MooVx/Project_mobil/Zdjecia etap 2/PCB.jpg

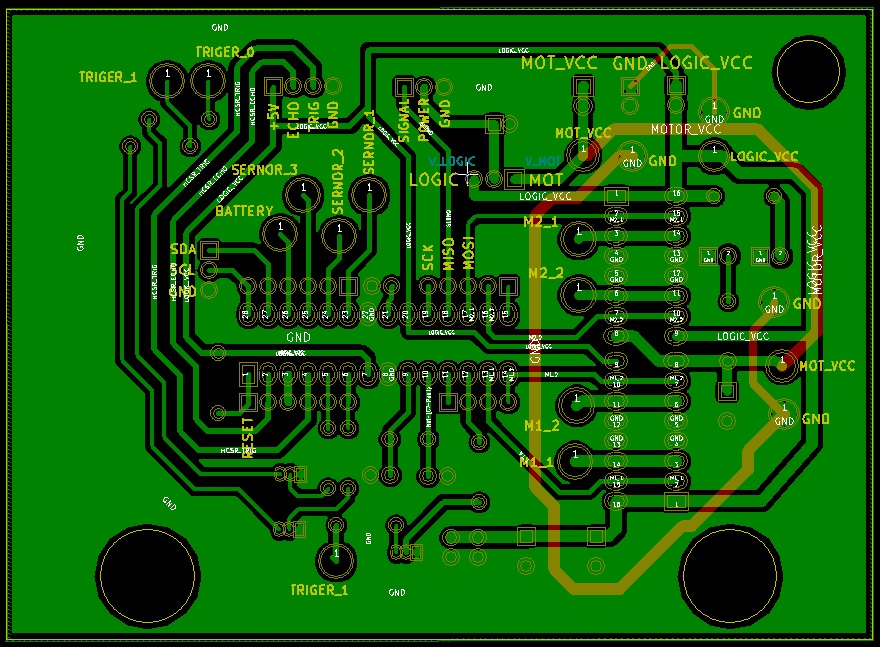
Zdjecia etap 2/PCB.jpg
