MooVx/Project_mobil/Zdjecia etap1/Sensor_trigger_calc_sch.jpg

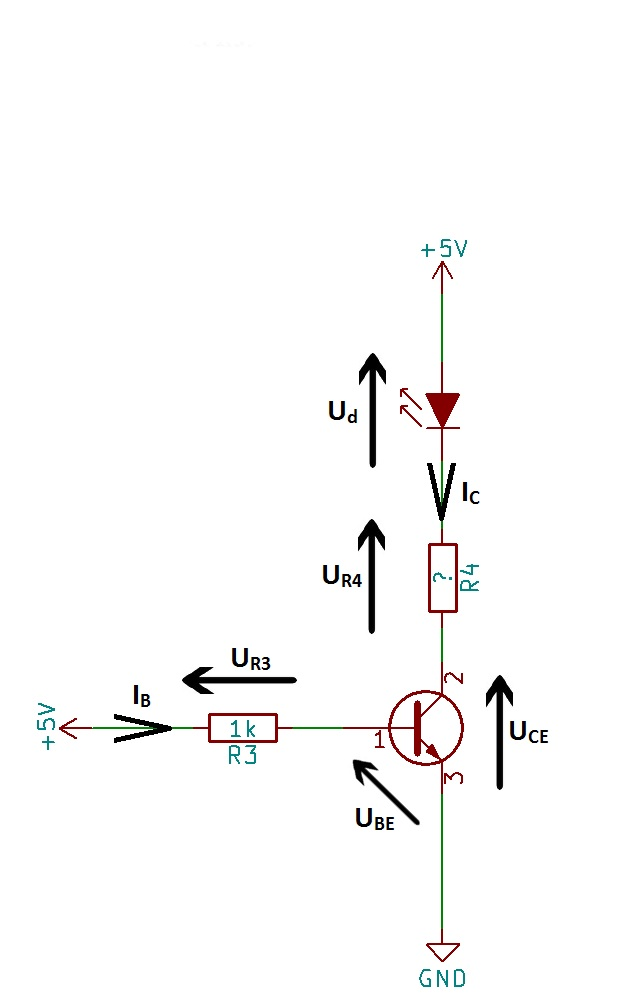
Zdjecia etap1/Sensor_trigger_calc_sch.jpg
