MooVx/Project_mobil/Zdjecia etap1/Wyprowadzenie_zasilania_sch.jpg

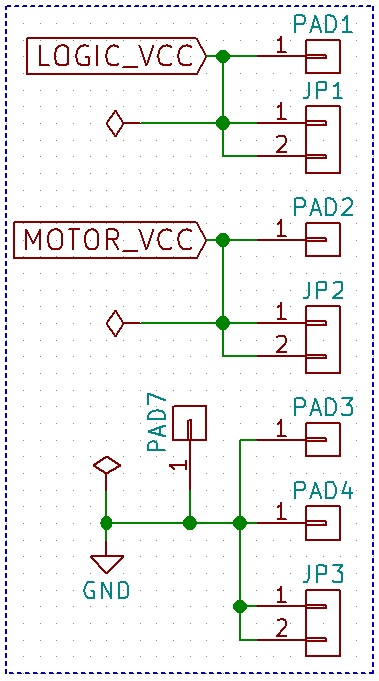
Zdjecia etap1/Wyprowadzenie_zasilania_sch.jpg
