MooVx/Project_mobil/Zdjecia etap 2/20170325_141044.jpg

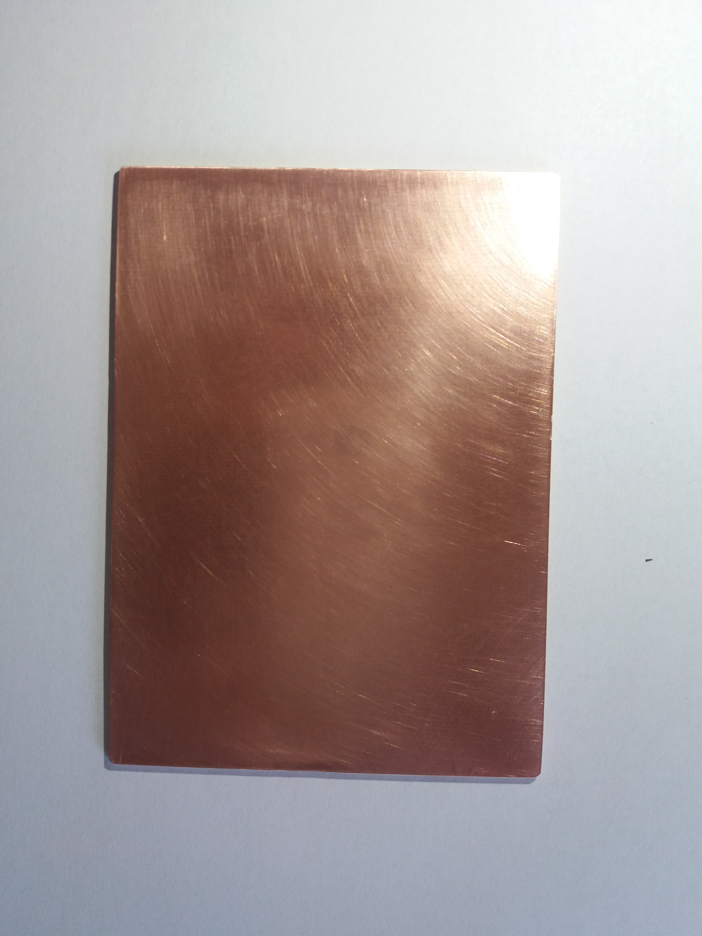
Zdjecia etap 2/20170325_141044.jpg
