MooVx/Project_mobil/Zdjecia etap 2/20170325_141538.jpg

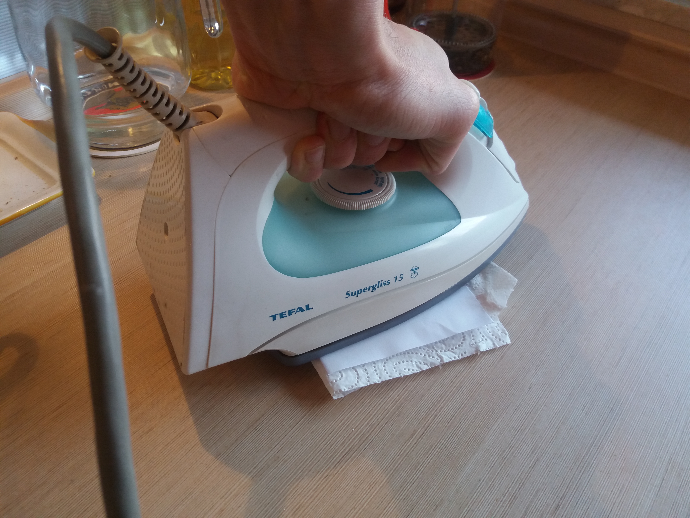
Zdjecia etap 2/20170325_141538.jpg
