MooVx/Project_mobil/Zdjecia etap 2/20170325_144329.jpg

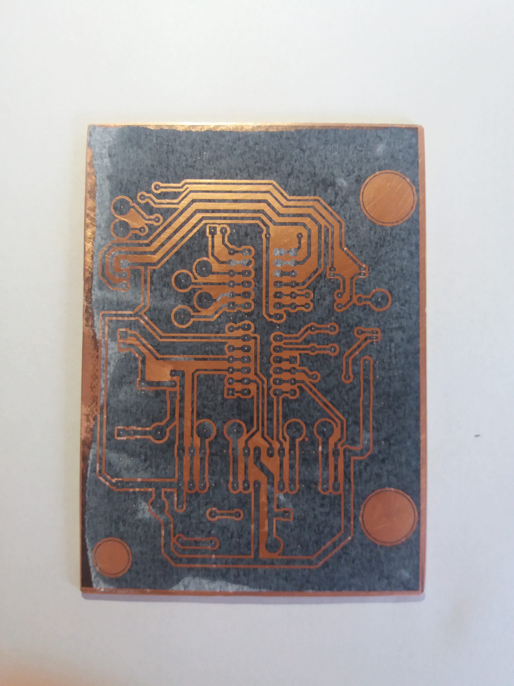
Zdjecia etap 2/20170325_144329.jpg
