MooVx/Project_mobil/Zdjecia etap 2/20170325_145545.jpg

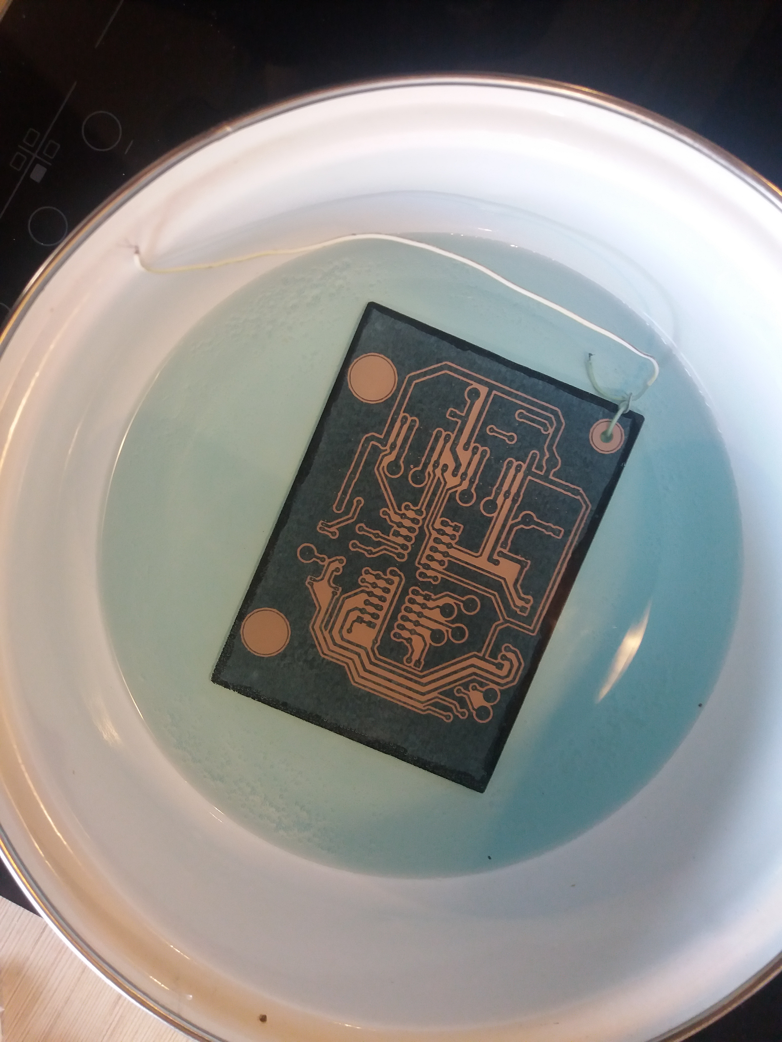
Zdjecia etap 2/20170325_145545.jpg
