MooVx/Project_mobil/Zdjecia etap 2/20170325_151509.jpg

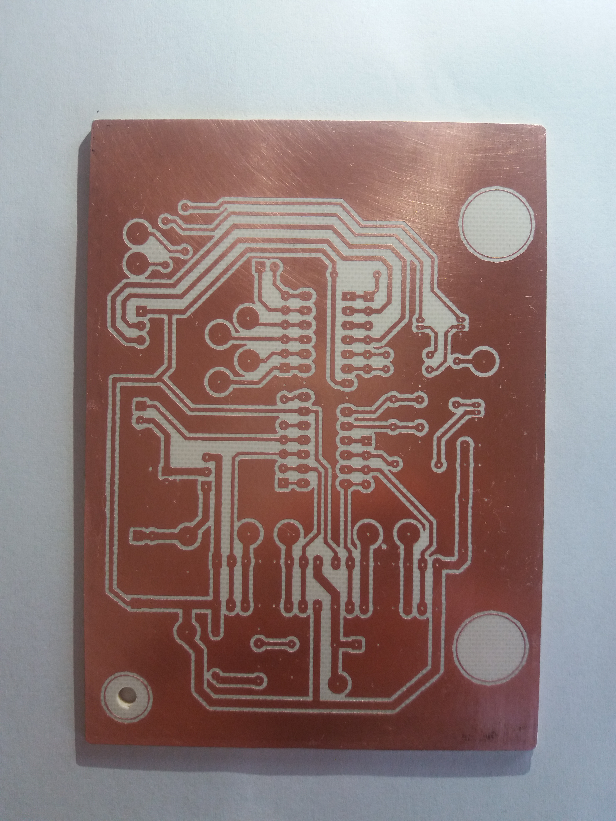
Zdjecia etap 2/20170325_151509.jpg
