MooVx/Project_mobil/Zdjecia etap 2/20170325_154758.jpg

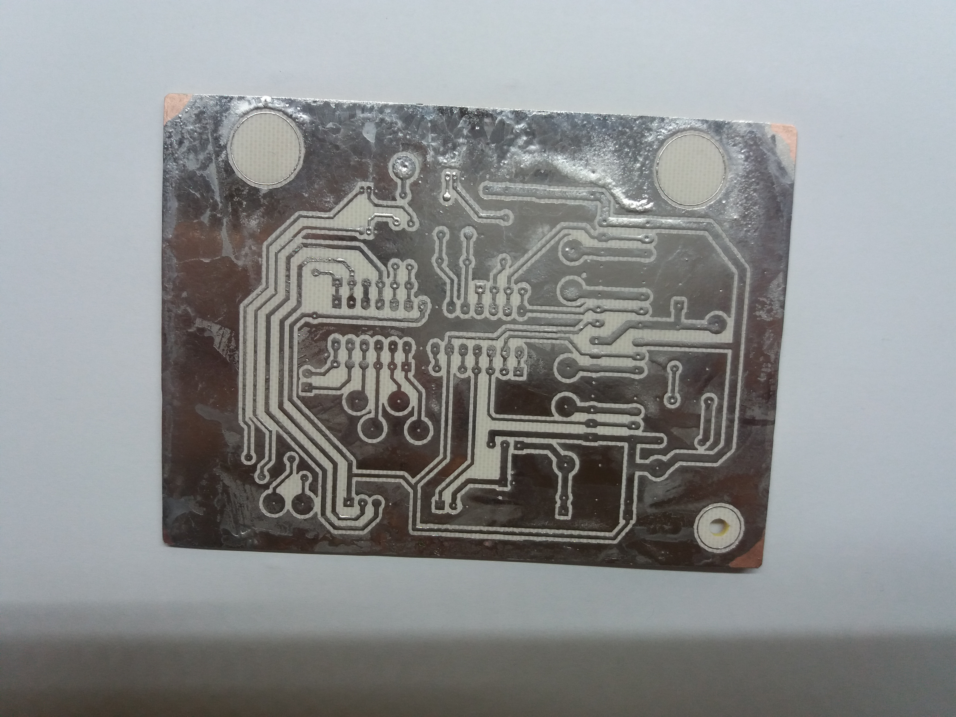
Zdjecia etap 2/20170325_154758.jpg
