MooVx/Project_mobil/Zdjecia etap 2/20170325_160751.jpg

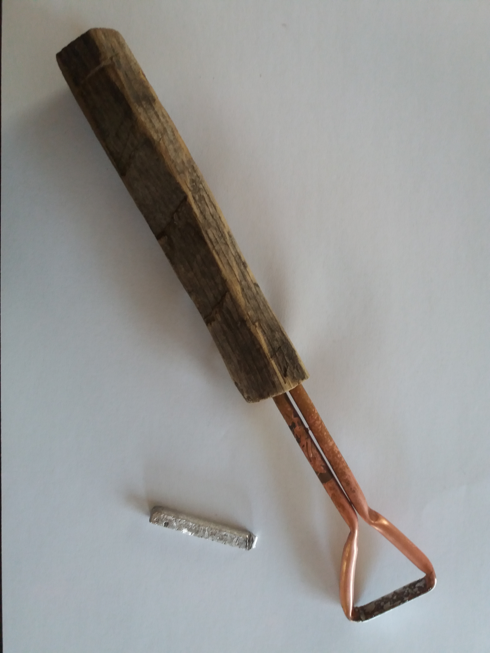
Zdjecia etap 2/20170325_160751.jpg
