MooVx/Project_mobil/Zdjecia etap 2/20170325_161032.jpg

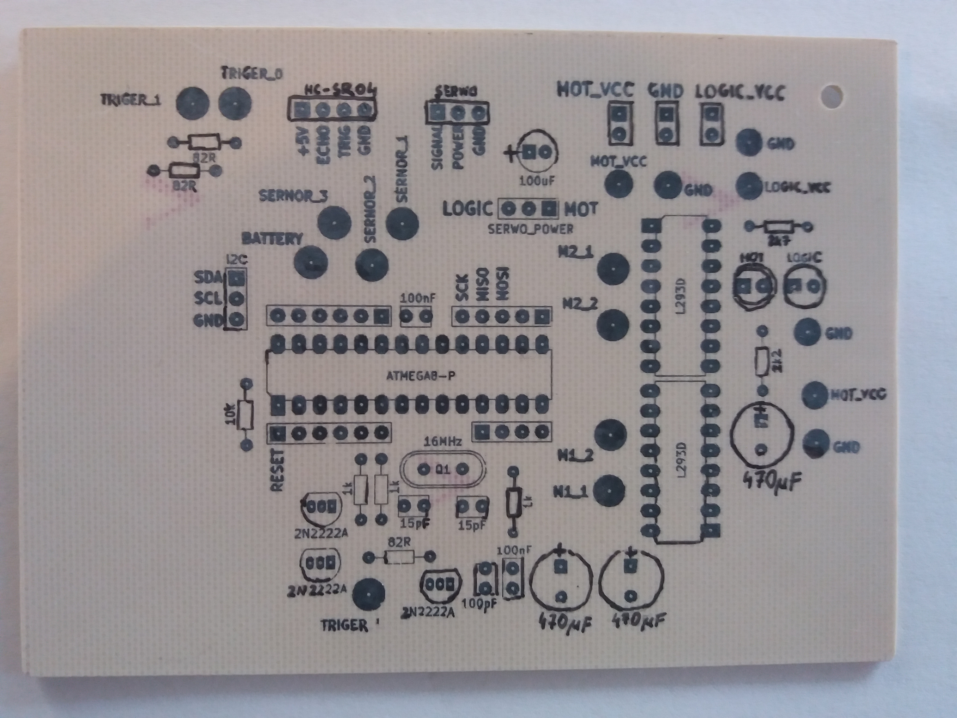
Zdjecia etap 2/20170325_161032.jpg
