MooVx/Project_mobil/Zdjecia etap 2/20170325_185022.jpg

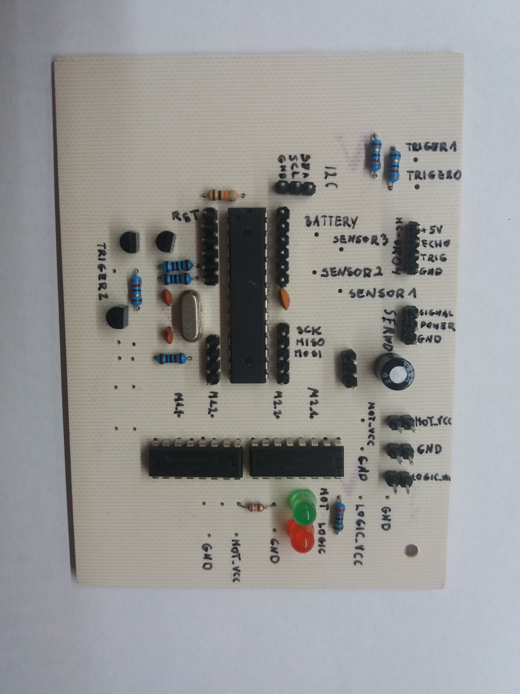
Zdjecia etap 2/20170325_185022.jpg
