MooVx/Project_mobil/Zdjecia etap 2/20170325_195133.jpg

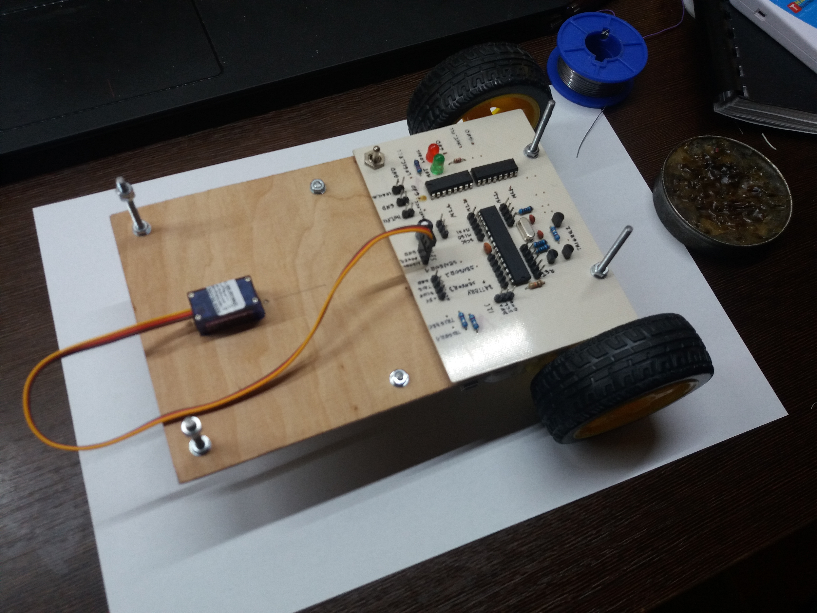
Zdjecia etap 2/20170325_195133.jpg
