MooVx/Project_mobil/Zdjecia etap 2/20170325_195144.jpg

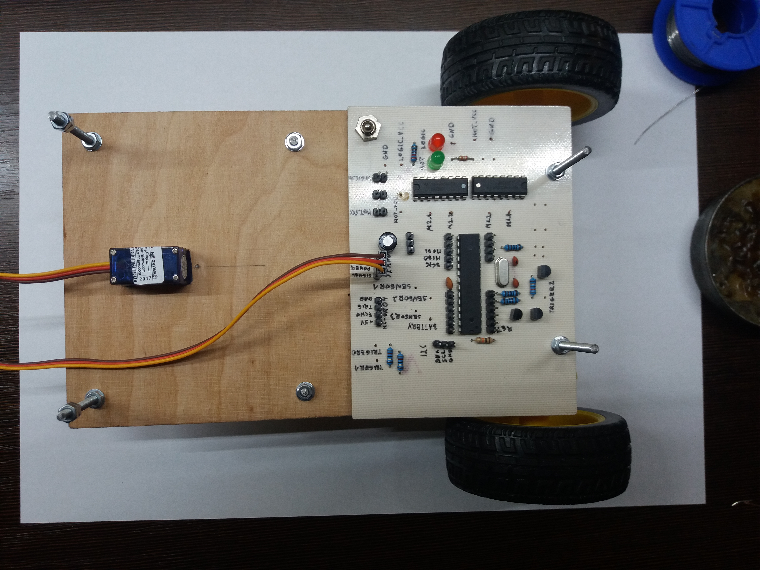
Zdjecia etap 2/20170325_195144.jpg
