MooVx/Project_mobil/Zdjecia etap 2/20170325_202553.jpg

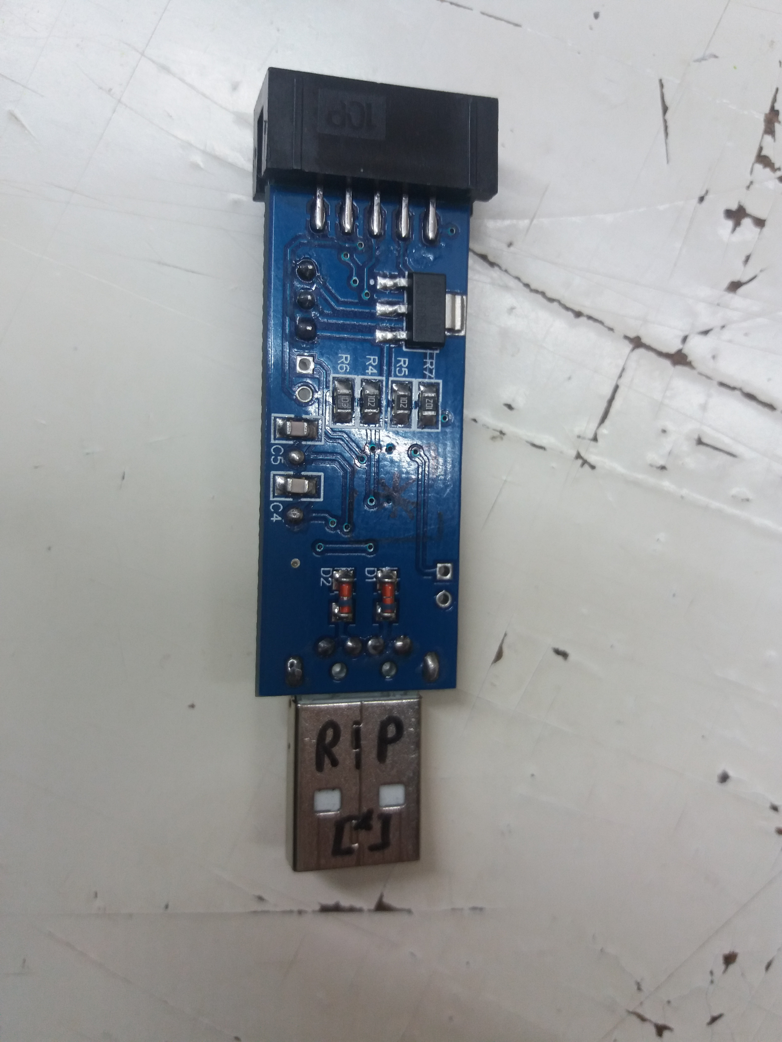
Zdjecia etap 2/20170325_202553.jpg
