MooVx/Project_mobil/Zdjecia etap 2/Mostek H.jpg

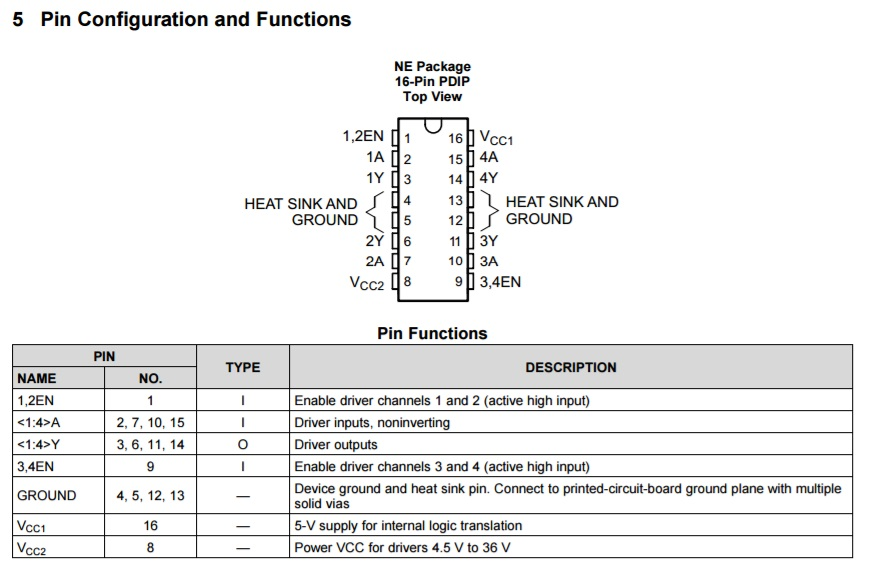
Zdjecia etap 2/Mostek H.jpg
