MooVx/Project_mobil/Zdjecia etap 2/Project_mobil_sch.pdf

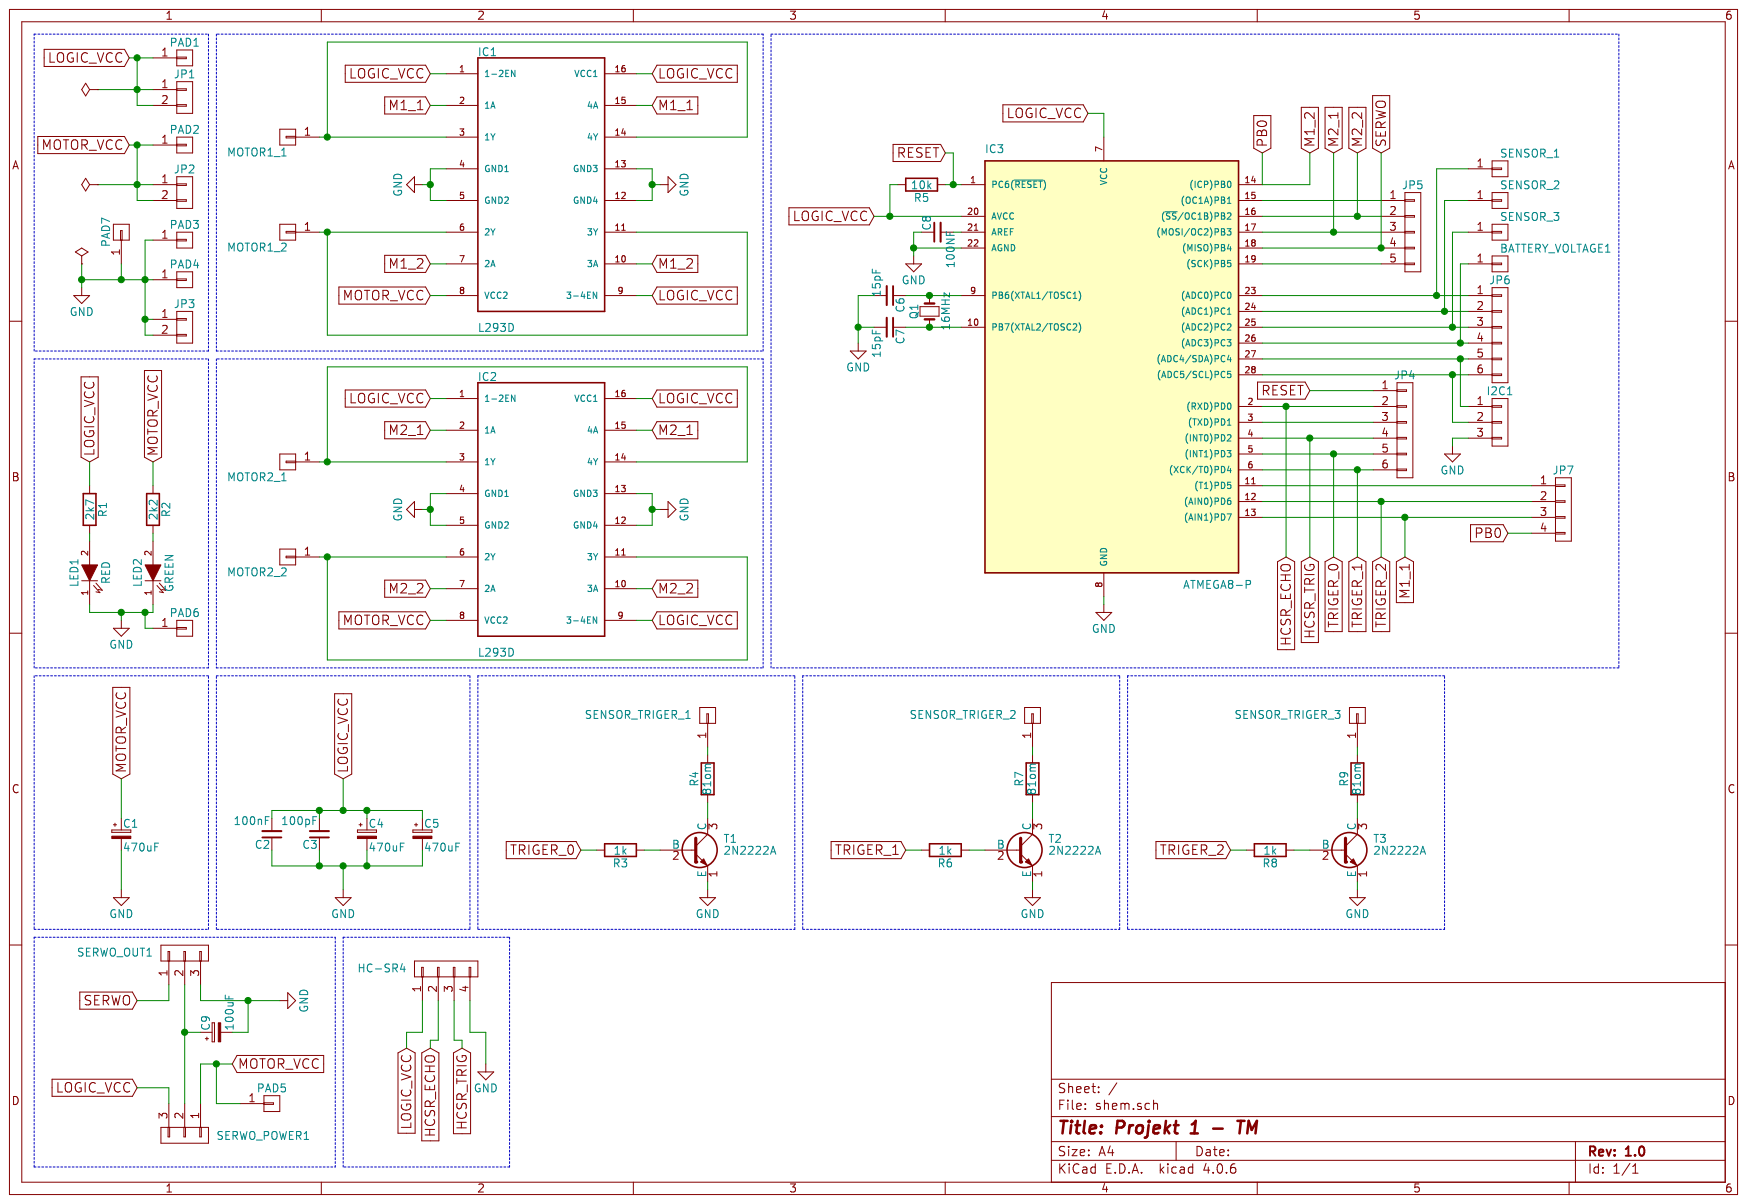
[picture p37: page 1]
