MooVx/Project_mobil/shematic/shem-B.Cu.pdf

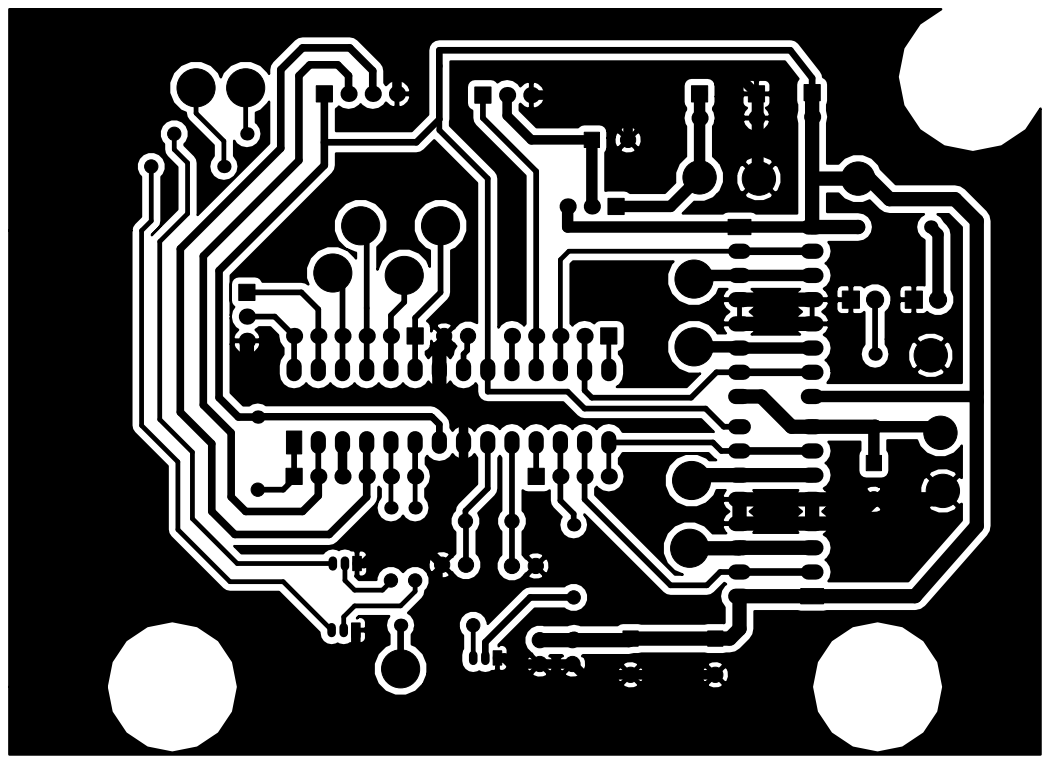
[picture p38: page 1]
