MooVx/Project_mobil/shematic/shem-Edge.Cuts.pdf

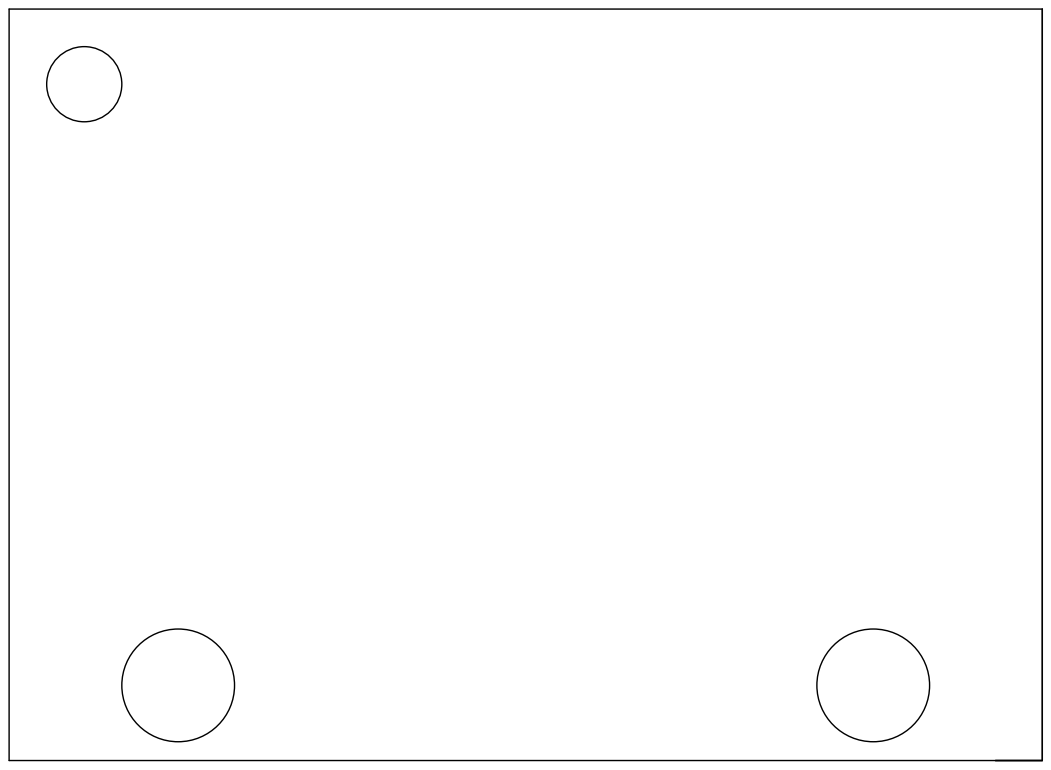
[picture p39: page 1]
