MooVx/Project_mobil/shematic/shem-F.Fab.pdf

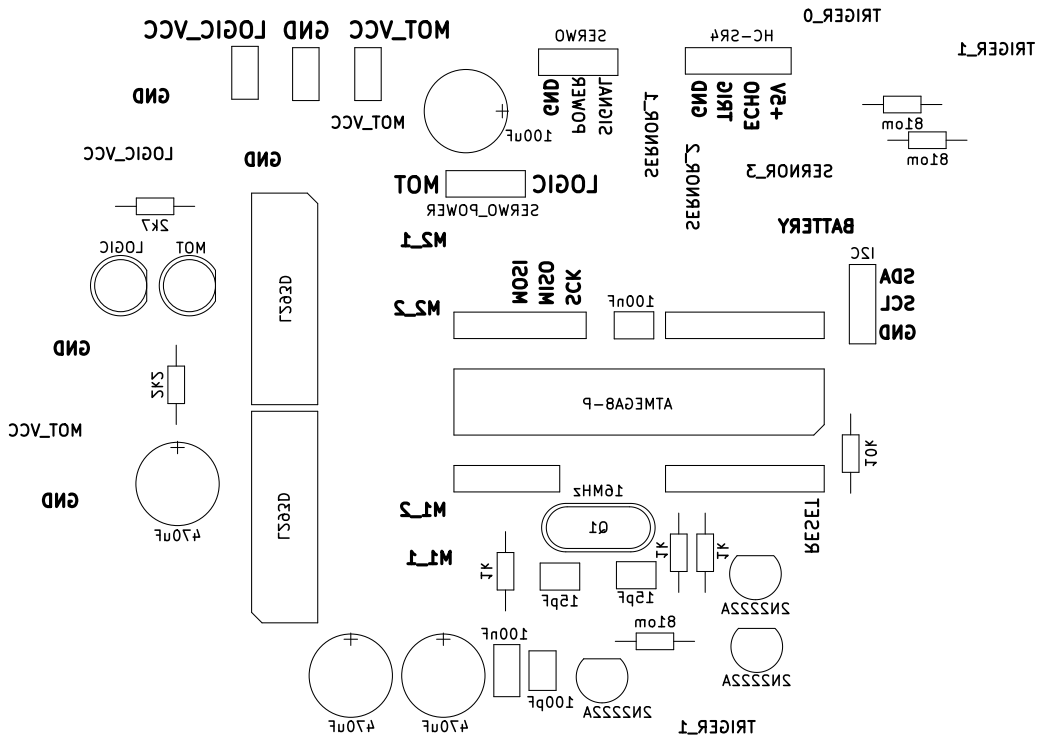
[picture p40: page 1]
