MooVx/Project_mobil/(list of files, drawings)

Other design files:
shematic/shem.dsn
