MooVx/Project_mobil/shematic/shem.kicad_pcb

## KiCad design shematic/shem.kicad_pcb (2017-03-25)

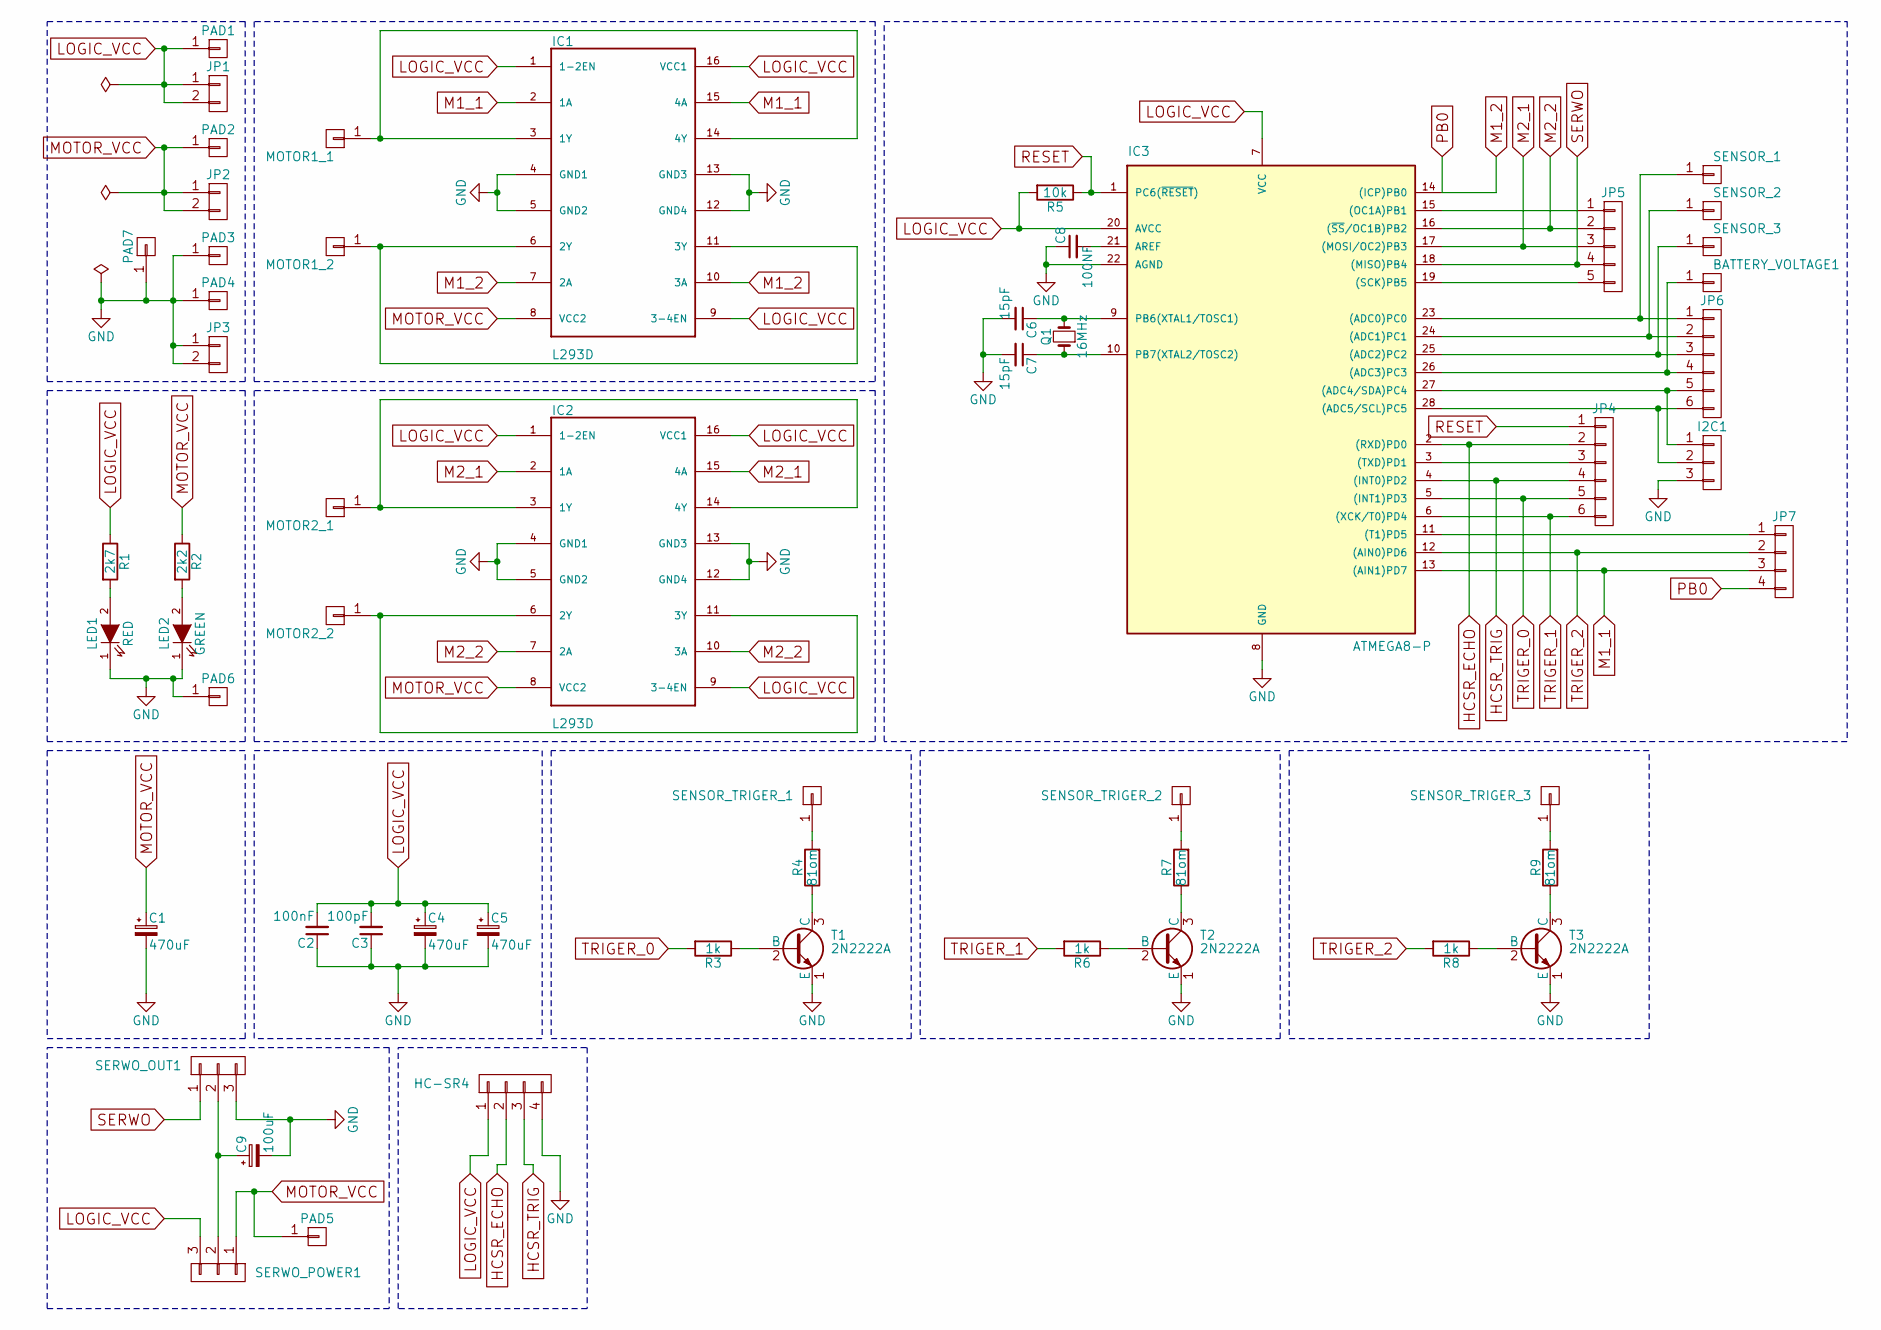
[picture p41: schematic shem.sch, Projekt 1 - TM]

Parts:
BATTERY_VOLTAGE1: CONN_01X01; SolderWirePad_single_1-5mmDrill
C1, C4, C5: 470uF; CP_Radial_D8.0mm_P3.80mm
C2: 100nF; C_Rect_L7.0mm_W2.0mm_P5.00mm
C3: 100pF; C_Disc_D3.8mm_W2.6mm_P2.50mm
C6, C7: 15pF; C_Disc_D3.4mm_W2.1mm_P2.50mm
C8: 100NF; C_Disc_D5.0mm_W2.5mm_P2.50mm
C9: 100uF; CP_Radial_D5.0mm_P2.00mm
HC-SR4: CONN_01X04; Pin_Header_Straight_1x04_Pitch2.54mm
I2C1: CONN_01X03; Pin_Header_Straight_1x03_Pitch2.54mm
IC1, IC2: L293D; DIP-16_W7.62mm_LongPads
IC3: ATMEGA8-P; DIP-28_W7.62mm_LongPads
JP1, JP2, JP3: CONN_01X02; Pin_Header_Straight_1x02_Pitch2.54mm
JP4, JP6: CONN_01X06; Pin_Header_Straight_1x06_Pitch2.54mm
JP5: CONN_01X05; Pin_Header_Straight_1x05_Pitch2.54mm
JP7: CONN_01X04; Pin_Header_Straight_1x04_Pitch2.54mm
LED1: RED; LED_D5.0mm
LED2: GREEN; LED_D5.0mm
MOTOR1_1, MOTOR1_2, MOTOR2_1, MOTOR2_2: CONN_01X01; SolderWirePad_single_1-5mmDrill
PAD1, PAD2, PAD3, PAD4, PAD5, PAD6, PAD7: CONN_01X01; SolderWirePad_single_1-2mmDrill
Q1: 16MHz; Crystal_HC49-U_Vertical
R1: 2k7; R_Axial_DIN0207_L6.3mm_D2.5mm_P10.16mm_Horizontal
R2: 2k2; R_Axial_DIN0207_L6.3mm_D2.5mm_P10.16mm_Horizontal
R3, R6, R8: 1k; R_Axial_DIN0207_L6.3mm_D2.5mm_P10.16mm_Horizontal
R4, R7, R9: 81om; R_Axial_DIN0207_L6.3mm_D2.5mm_P10.16mm_Horizontal
R5: 10k; R_Axial_DIN0207_L6.3mm_D2.5mm_P10.16mm_Horizontal
SENSOR_1, SENSOR_2, SENSOR_3: CONN_01X01; SolderWirePad_single_1-5mmDrill
SENSOR_TRIGER_1, SENSOR_TRIGER_2, SENSOR_TRIGER_3: CONN_01X01; SolderWirePad_single_1-5mmDrill
SERWO_OUT1: CONN_01X03; Pin_Header_Straight_1x03_Pitch2.54mm
SERWO_POWER1: CONN_01X03; Pin_Header_Straight_1x03_Pitch2.54mm
T1, T2, T3: 2N2222A; TO-92_Molded_Narrow

Connections:
GND: C1.2, C2.1, C3.1, C4.2, C5.2, C6.2, C7.2, C8.1, C9.2, HC-SR4.4, I2C1.3, IC1.4 (GND1), IC1.5 (GND2), IC1.12 (GND4), IC1.13 (GND3), IC2.4 (GND1), IC2.5 (GND2), IC2.12 (GND4), IC2.13 (GND3), IC3.8 (GND), IC3.22 (AGND), JP3.1, JP3.2, LED1.1 (K), LED2.1 (K), PAD3.1, PAD4.1, PAD6.1, PAD7.1, SERWO_OUT1.3, T1.1 (E), T2.1 (E), T3.1 (E); also elsewhere on the board
HCSR_ECHO: HC-SR4.2, IC3.2 ((RXD)PD0), JP4.2
HCSR_TRIG: HC-SR4.3, IC3.4 ((INT0)PD2), JP4.4
LOGIC_VCC: C2.2, C3.2, C4.1, C5.1, HC-SR4.1, IC1.1 (1-2EN), IC1.9 (3-4EN), IC1.16 (VCC1), IC2.1 (1-2EN), IC2.9 (3-4EN), IC2.16 (VCC1), IC3.7 (VCC), IC3.20 (AVCC), JP1.1, JP1.2, PAD1.1, R1.1, R5.2, SERWO_POWER1.3; also elsewhere on the board
M1_1: IC1.2 (1A), IC1.15 (4A), IC3.13 ((AIN1)PD7), JP7.3
M1_2: IC1.7 (2A), IC1.10 (3A), IC3.14 ((ICP)PB0), JP7.4
M2_1: IC2.2 (1A), IC2.15 (4A), IC3.17 ((MOSI/OC2)PB3), JP5.3
M2_2: IC2.7 (2A), IC2.10 (3A), IC3.16 ((~SS~/OC1B)PB2), JP5.2
MOTOR_VCC: C1.1, IC1.8 (VCC2), IC2.8 (VCC2), JP2.1, JP2.2, PAD2.1, PAD5.1, R2.1, SERWO_POWER1.1; also elsewhere on the board
unnamed 9: BATTERY_VOLTAGE1.1, IC3.26 ((ADC3)PC3), JP6.4; also elsewhere on the board
unnamed: C6.1, IC3.9 (PB6(XTAL1/TOSC1)), Q1.2
unnamed: C7.1, IC3.10 (PB7(XTAL2/TOSC2)), Q1.1
unnamed: C8.2, IC3.21 (AREF)
unnamed 13: C9.1, SERWO_OUT1.2, SERWO_POWER1.2; also elsewhere on the board
unnamed 14: I2C1.1, IC3.27 ((ADC4/SDA)PC4), JP6.5; also elsewhere on the board
unnamed 15: I2C1.2, IC3.28 ((ADC5/SCL)PC5), JP6.6; also elsewhere on the board
unnamed: IC1.6 (2Y), IC1.11 (3Y), MOTOR1_2.1
unnamed: IC1.3 (1Y), IC1.14 (4Y), MOTOR1_1.1
unnamed: IC2.6 (2Y), IC2.11 (3Y), MOTOR2_2.1
unnamed: IC2.3 (1Y), IC2.14 (4Y), MOTOR2_1.1
unnamed: IC3.3 ((TXD)PD1), JP4.3
unnamed: IC3.11 ((T1)PD5), JP7.1
unnamed: IC3.15 ((OC1A)PB1), JP5.1
unnamed: IC3.19 ((SCK)PB5), JP5.5
unnamed: IC3.23 ((ADC0)PC0), JP6.1, SENSOR_1.1
unnamed: IC3.24 ((ADC1)PC1), JP6.2, SENSOR_2.1
unnamed: IC3.25 ((ADC2)PC2), JP6.3, SENSOR_3.1
unnamed: LED1.2 (A), R1.2
unnamed: LED2.2 (A), R2.2
unnamed: R3.1, T1.2 (B)
unnamed: R4.1, T1.3 (C)
unnamed: R4.2, SENSOR_TRIGER_1.1
unnamed: R6.1, T2.2 (B)
unnamed: R7.1, T2.3 (C)
unnamed: R7.2, SENSOR_TRIGER_2.1
unnamed: R8.1, T3.2 (B)
unnamed: R9.1, T3.3 (C)
unnamed: R9.2, SENSOR_TRIGER_3.1
RESET: IC3.1 (PC6(~RESET~)), JP4.1, R5.1
SERWO: IC3.18 ((MISO)PB4), JP5.4, SERWO_OUT1.1; also elsewhere on the board
TRIGER_0: IC3.5 ((INT1)PD3), JP4.5, R3.2
TRIGER_1: IC3.6 ((XCK/T0)PD4), JP4.6, R6.2
TRIGER_2: IC3.12 ((AIN0)PD6), JP7.2, R8.2

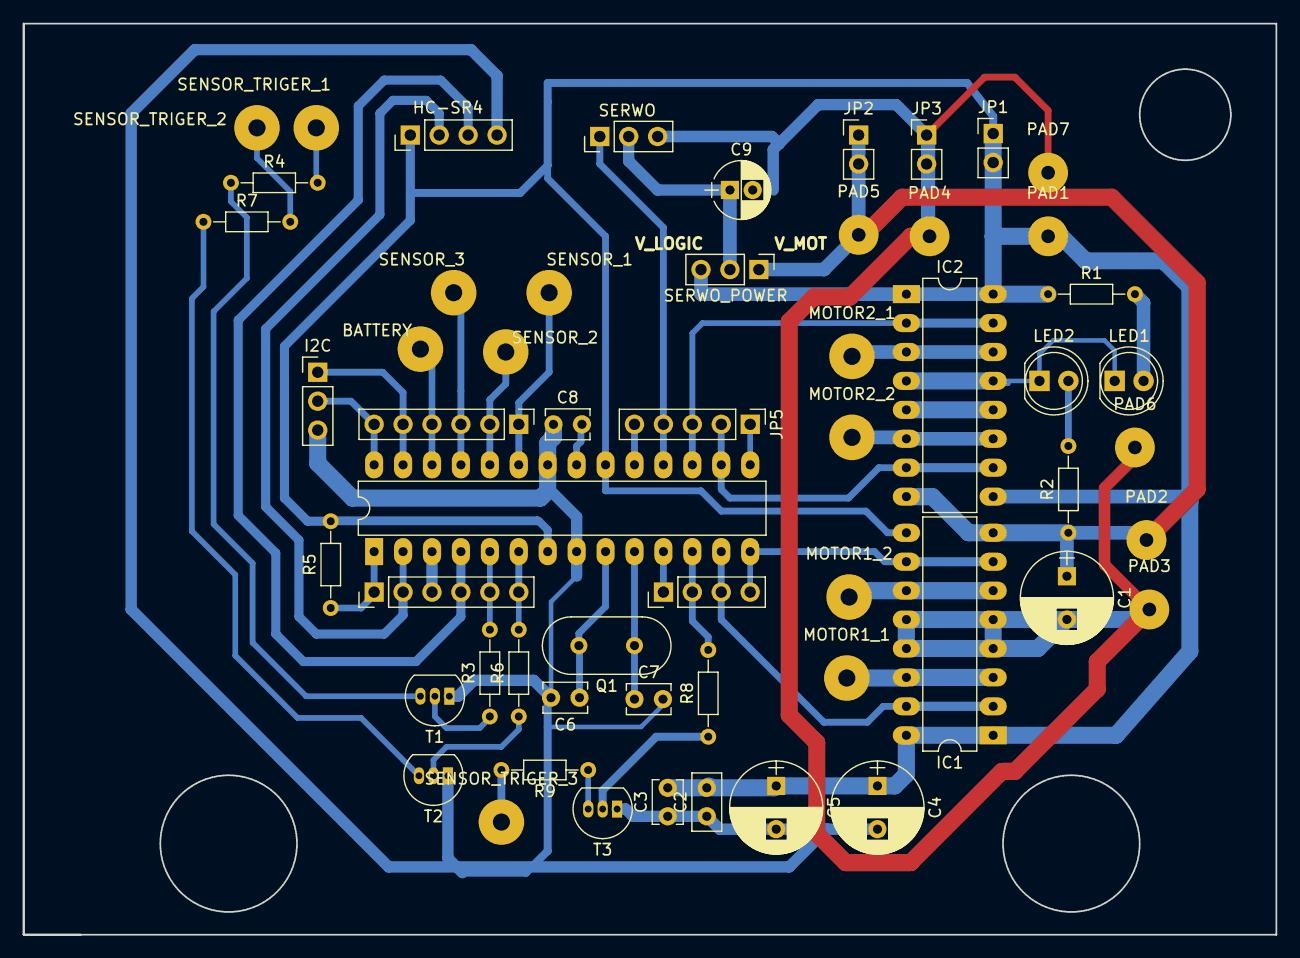
[picture p42: board shem.kicad_pcb from above]

Board: 2 copper layers, 110.0 x 80.0 mm, 56 parts (0 on the bottom side), 43 nets.

Other parts of the board:
BATTERY: CONN_01X01; SolderWirePad_single_1-5mmDrill
I2C: CONN_01X03; Pin_Header_Straight_1x03_Pitch2.54mm
SERWO: CONN_01X03; Pin_Header_Straight_1x03_Pitch2.54mm
SERWO_POWER: CONN_01X03; Pin_Header_Straight_1x03_Pitch2.54mm

Their connections:
GND: I2C.3, SERWO.3; also elsewhere on the board
LOGIC_VCC: SERWO_POWER.3; also elsewhere on the board
MOTOR_VCC: SERWO_POWER.1; also elsewhere on the board
unnamed 9: BATTERY.1; also elsewhere on the board
unnamed 13: SERWO.2, SERWO_POWER.2; also elsewhere on the board
unnamed 14: I2C.1; also elsewhere on the board
unnamed 15: I2C.2; also elsewhere on the board
SERWO: SERWO.1; also elsewhere on the board
