MooVx/Project_mobil/(commit log)

2017-03-23 added some outputs
    [board_schematic.sch]
2017-03-23 board start
    [board_schematic.brd]
2017-03-25 pcb shem finish
    [board_schematic.brd, board_schematic.sch, shem.dsn, shem.kicad_pcb, shem.sch]
2017-03-25 Updata
    Wykonana plytka
    [shem.kicad_pcb]
