MooVx/Project_mobil/Zdjecia etap 2/20170325_150505.jpg

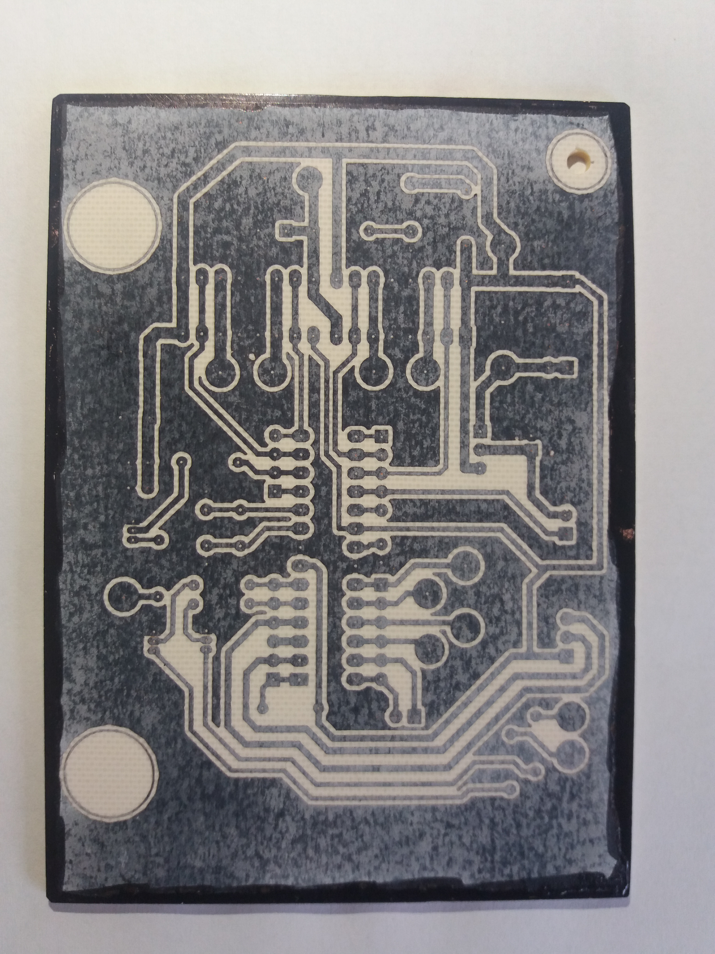
Zdjecia etap 2/20170325_150505.jpg
